RealFlightSystems/ufo29/sw/Arduino/ufo29/README.md

## Neopixel for Attiny85

- Support AttinyCore and Adafruit Neopixel library for saucer
- Support a few common programmable modes (with button)
