RealFlightSystems/ufo29/hw/ufo-29b.pdf

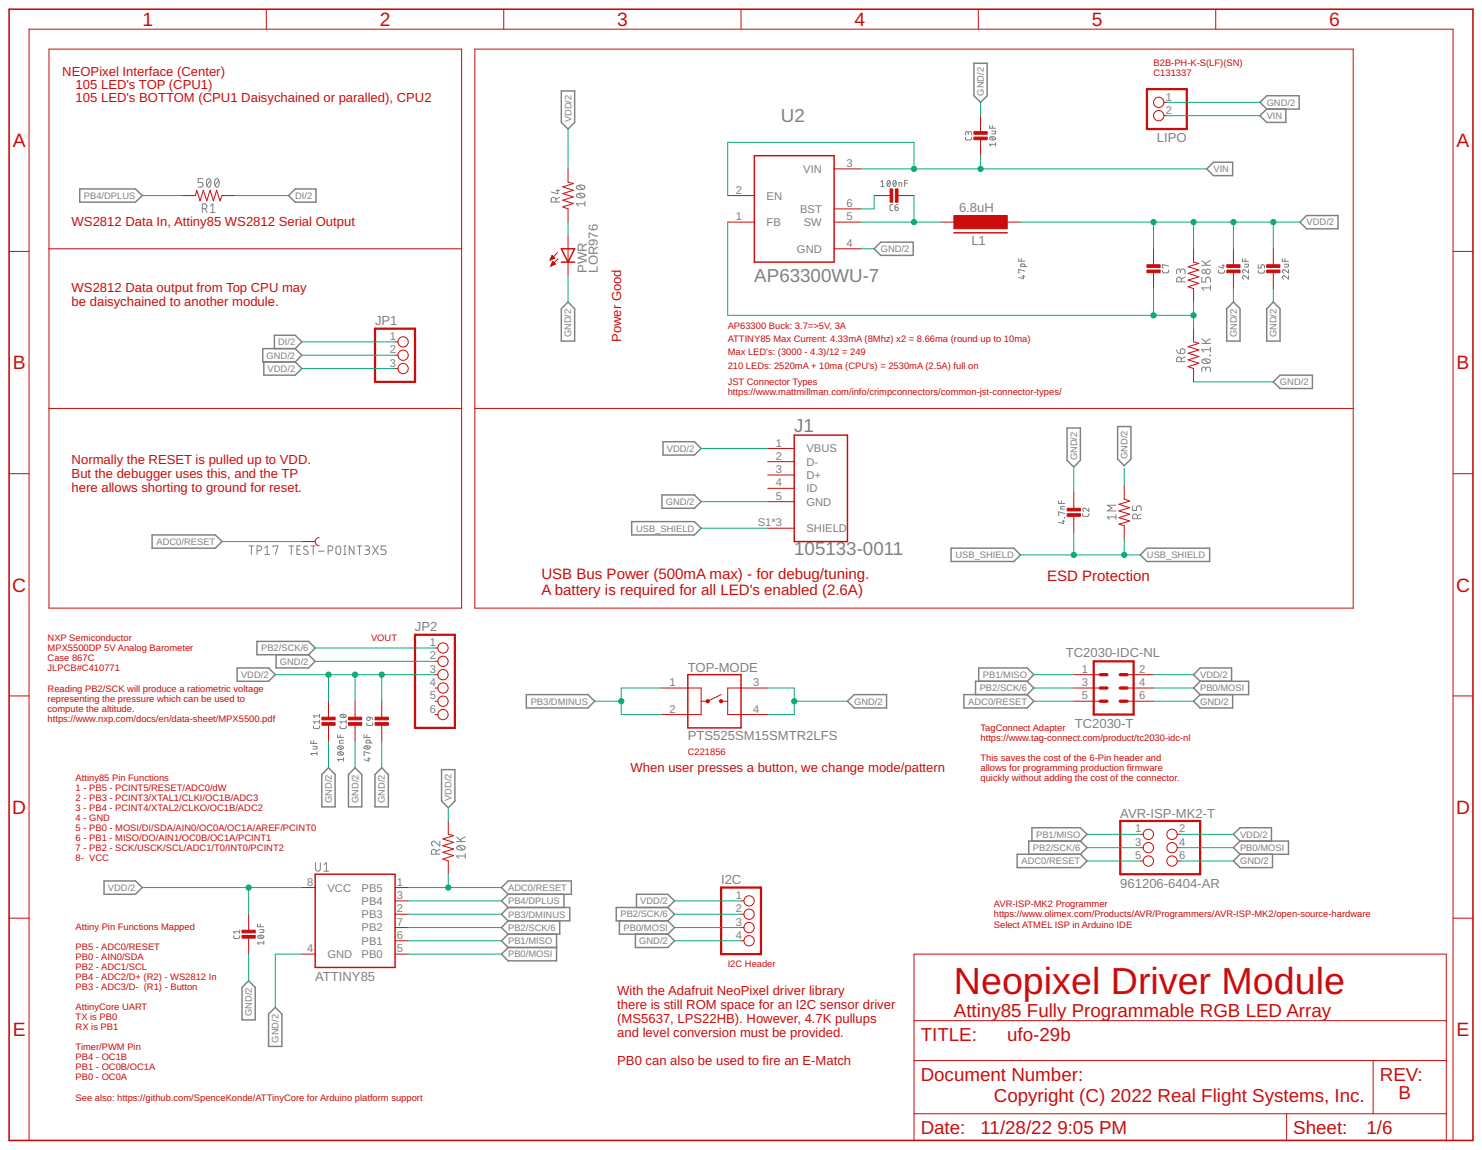
[picture p1: page 1]

NEOPixel Interface (Center) WS2812 Data In, Attiny85 WS2812 Serial Output
105 LED's TOP (CPU1) 105 LED's BOTTOM (CPU1 Daisychained or paralled), CPU2

WS2812 Data output from Top CPU may be daisychained to another module.

ATTINY85 Max Current: 4.33mA (8Mhz) x2 = 8.66ma (round up to 10ma) AP63300 Buck: 3.7=>5V, 3A Max LED's: (3000 - 4.3)/12 = 249

210 LEDs: 2520mA + 10ma (CPU's) = 2530mA (2.5A) full on
JST Connector Types https://www.mattmillman.com/info/crimpconnectors/common-jst-connector-types/

Normally the RESET is pulled up to VDD. But the debugger uses this, and the TP

here allows shorting to ground for reset.

USB Bus Power (500mA max) - for debug/tuning. A battery is required for all LED's enabled (2.6A)

NXP Semiconductor MPX5500DP 5V Analog Barometer Case 867C

JLPCB#C410771 Reading PB2/SCK will produce a ratiometric voltage

representing the pressure which can be used to
compute the altitude. https://www.nxp.com/docs/en/data-sheet/MPX5500.pdf

TagConnect Adapter https://www.tag-connect.com/product/tc2030-idc-nl This saves the cost of the 6-Pin header and

When user presses a button, we change mode/pattern

allows for programming production firmware
quickly without adding the cost of the connector.

3 - PB4 - PCINT4/XTAL2/CLKO/OC1B/ADC2
4 - GND
5 - PB0 - MOSI/DI/SDA/AIN0/OC0A/OC1A/AREF/PCINT0
6 - PB1 - MISO/DO/AIN1/OC0B/OC1A/PCINT1
7 - PB2 - SCK/USCK/SCL/ADC1/T0/INT0/PCINT2
8- VCC

AVR-ISP-MK2 Programmer https://www.olimex.com/Products/AVR/Programmers/AVR-ISP-MK2/open-source-hardware Select ATMEL ISP in Arduino IDE
Neopixel Driver Module
Attiny85 Fully Programmable RGB LED Array
TITLE:

Attiny Pin Functions Mapped PB5 - ADC0/RESET PB0 - AIN0/SDA

PB2 - ADC1/SCL PB4 - ADC2/D+ (R2) - WS2812 In PB3 - ADC3/D- (R1) - Button AttinyCore UART

With the Adafruit NeoPixel driver library
there is still ROM space for an I2C sensor driver
(MS5637, LPS22HB). However, 4.7K pullups and level conversion must be provided. PB0 can also be used to fire an E-Match

TX is PB0 RX is PB1 Timer/PWM Pin PB4 - OC1B

See also: https://github.com/SpenceKonde/ATTinyCore for Arduino platform support

Document Number: Copyright (C) 2022 Real Flight Systems, Inc. | REV: B

Date: 11/28/22 9:05 PM | Sheet: 1/6

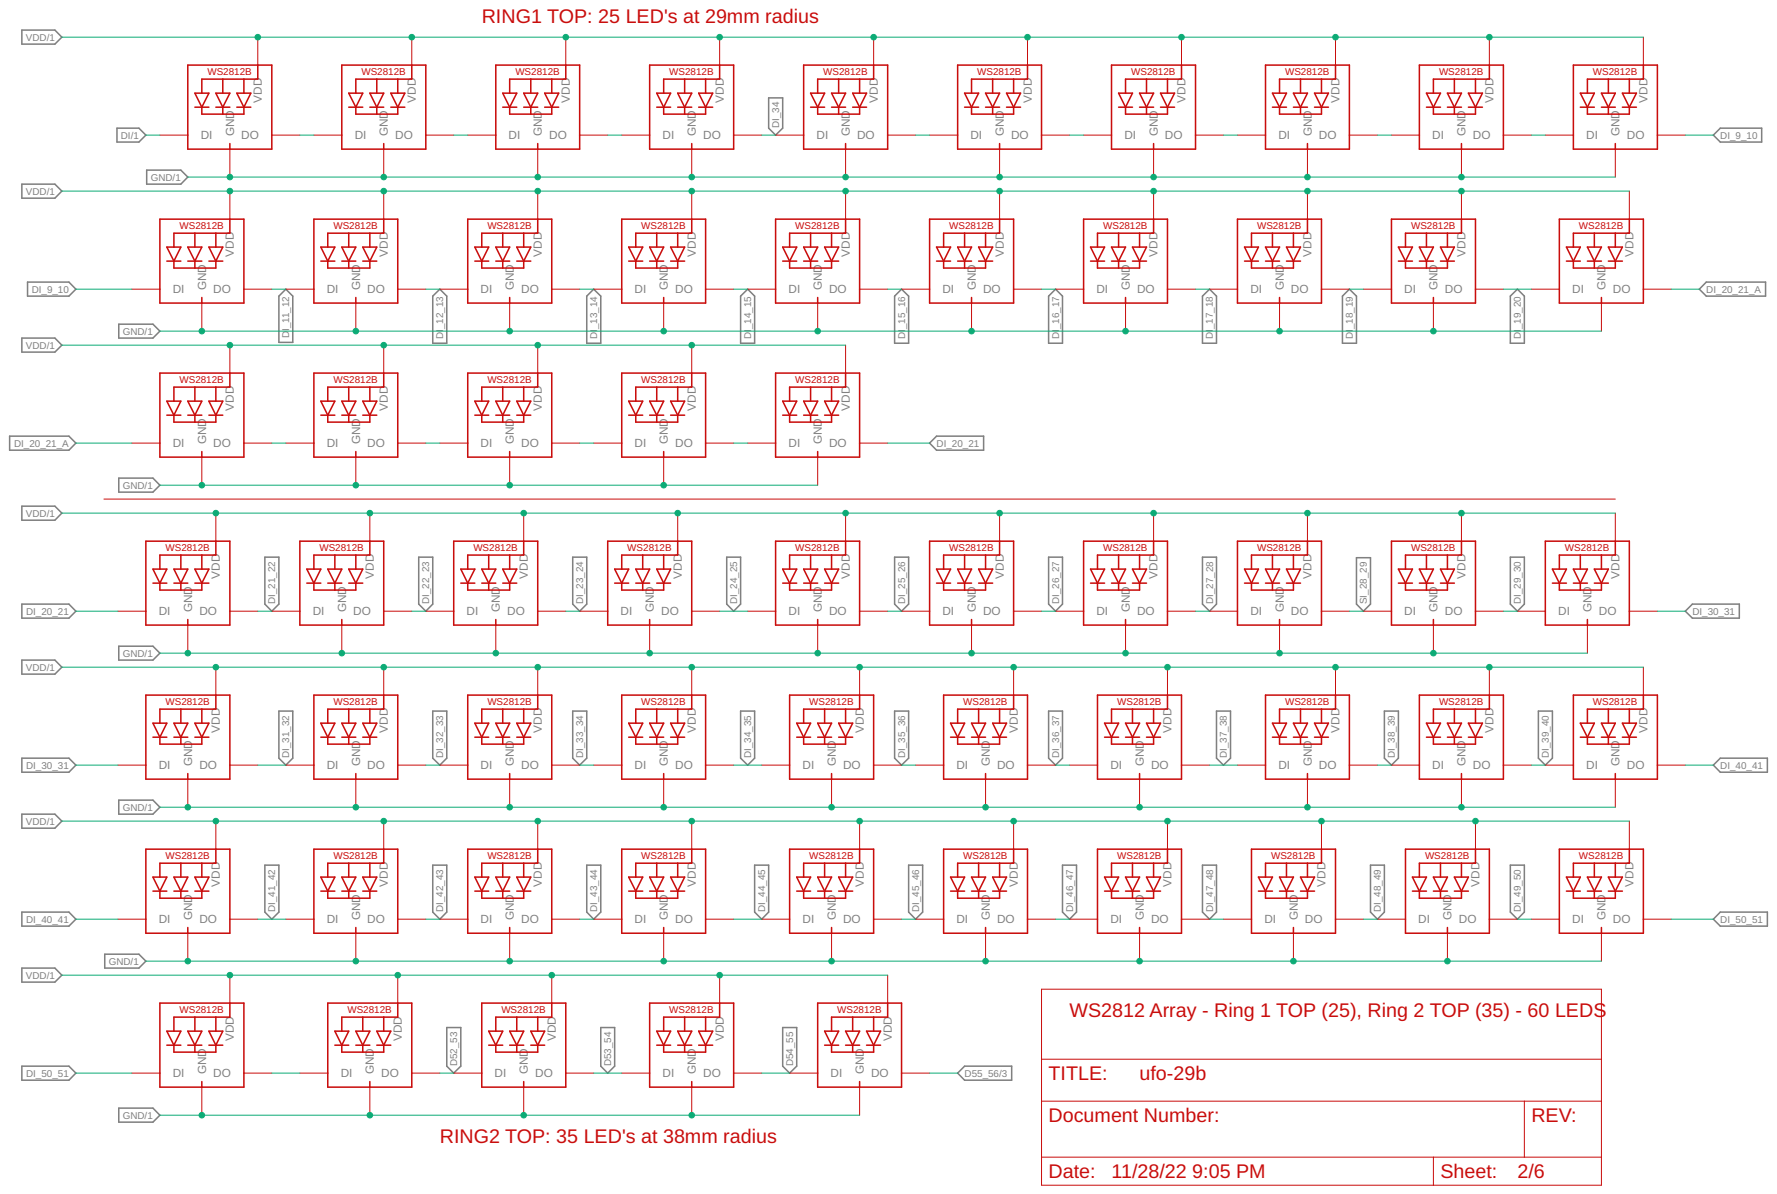
[picture p2: page 2]

RING1 TOP: 25 LED's at 29mm radius

Document Number: | REV:

RING2 TOP: 35 LED's at 38mm radius

Date: 11/28/22 9:05 PM | Sheet: 2/6

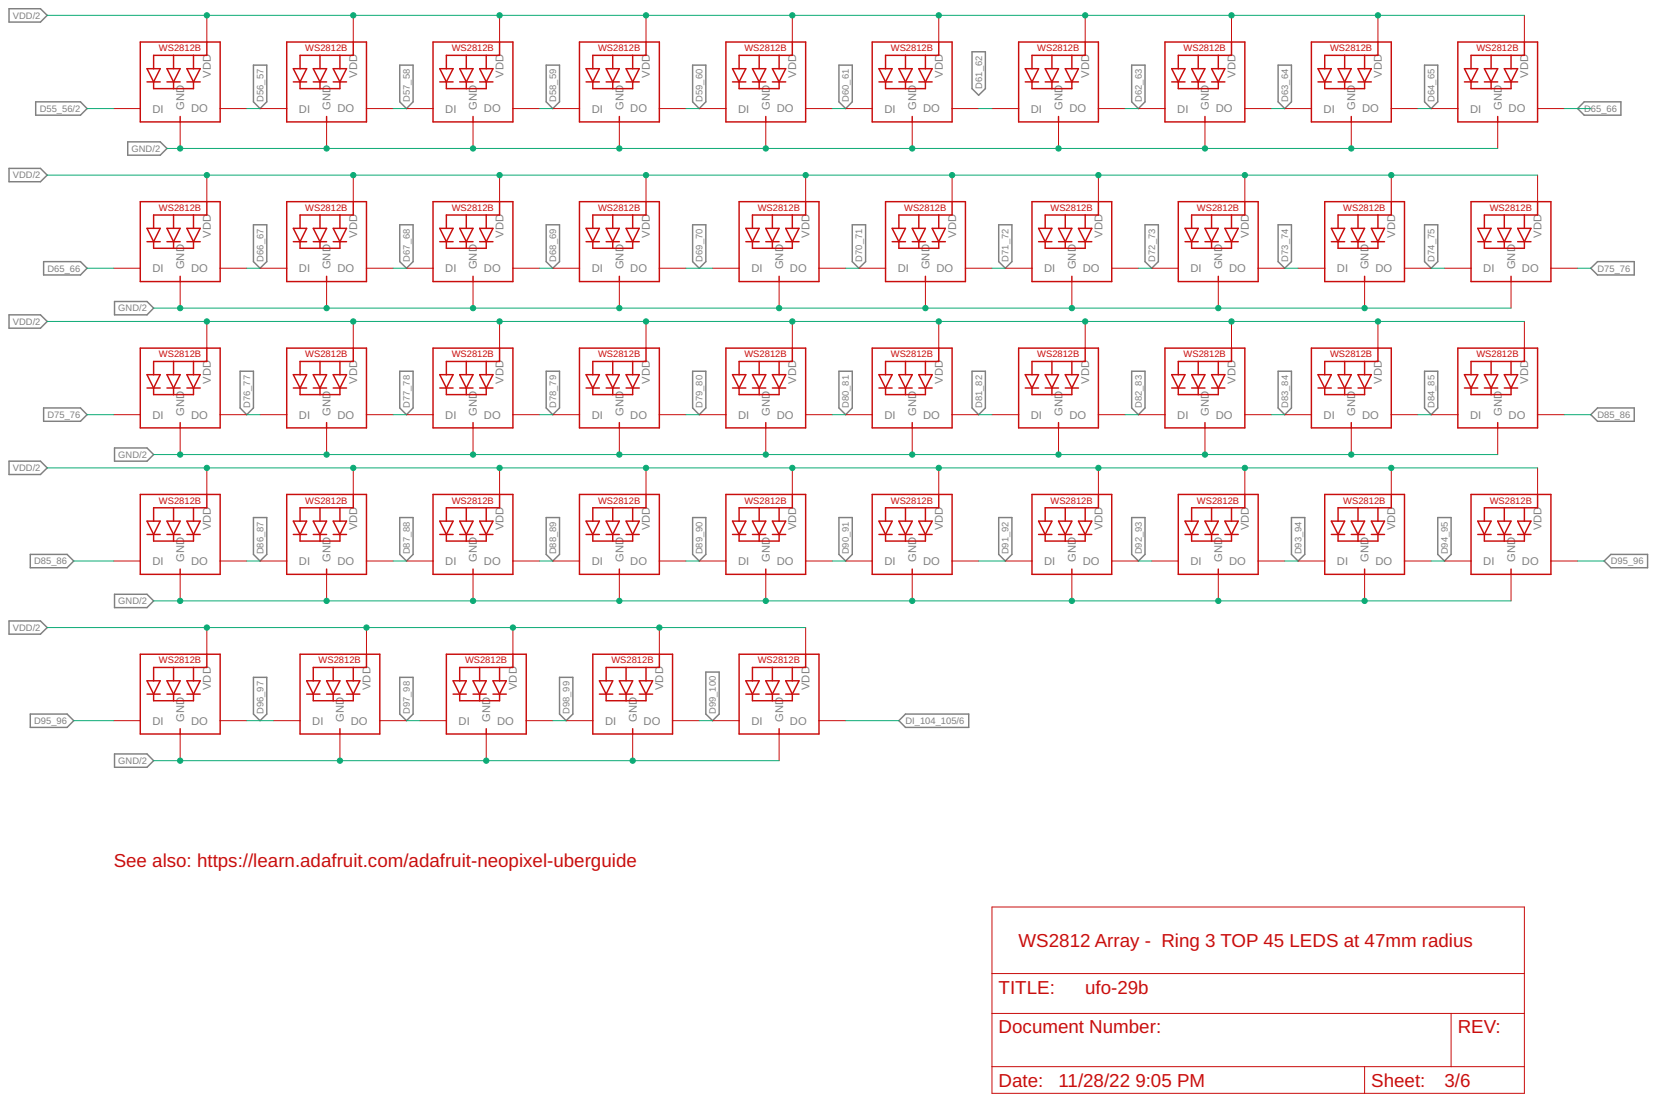
[picture p3: page 3]

See also: https://learn.adafruit.com/adafruit-neopixel-uberguide

Document Number: | REV:

Date: 11/28/22 9:05 PM | Sheet: 3/6

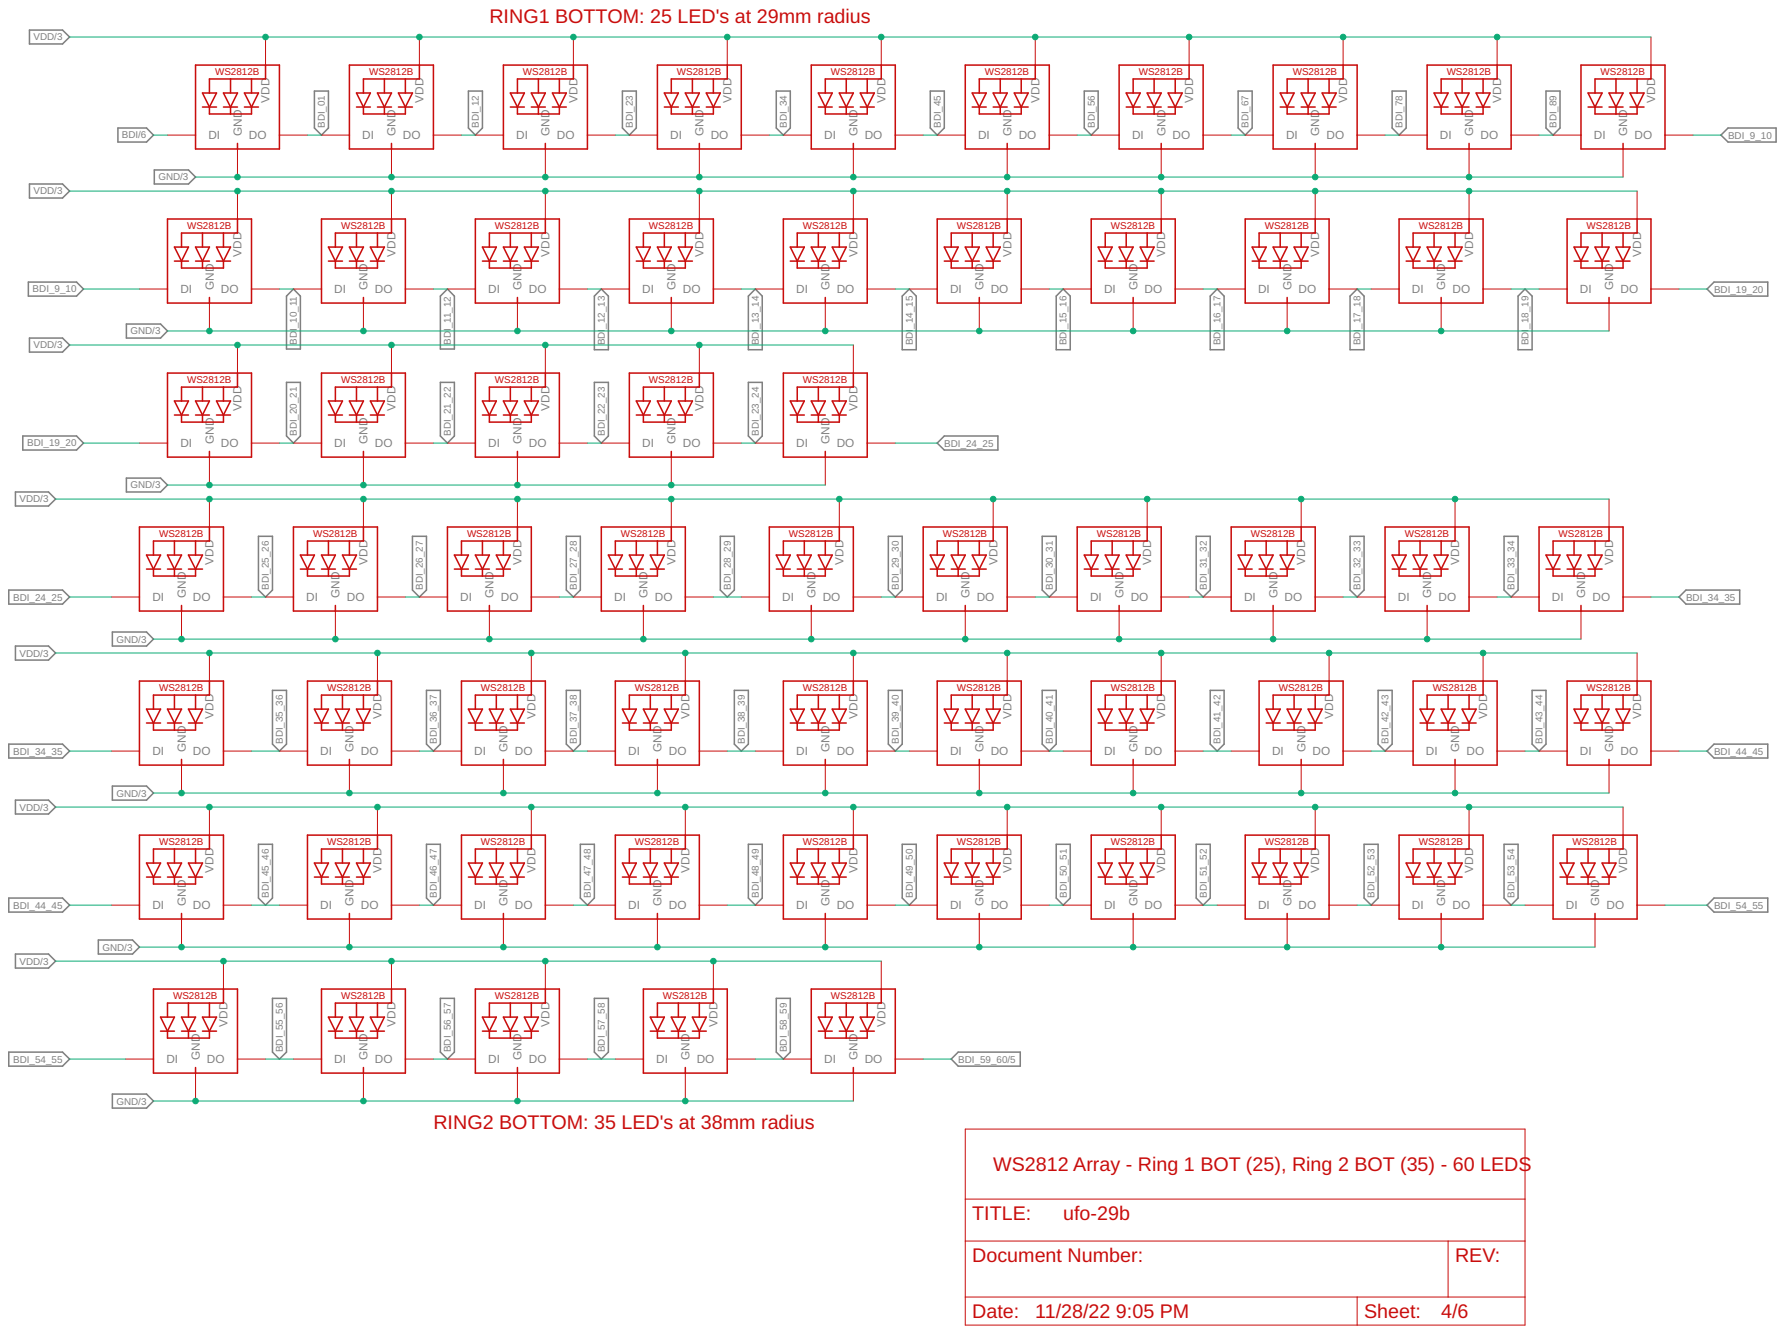
[picture p4: page 4]

RING2 BOTTOM: 35 LED's at 38mm radius

WS2812 Array - Ring 1 BOT (25), Ring 2 BOT (35) - 60 LEDS

Document Number: | REV:

Date: 11/28/22 9:05 PM | Sheet: 4/6

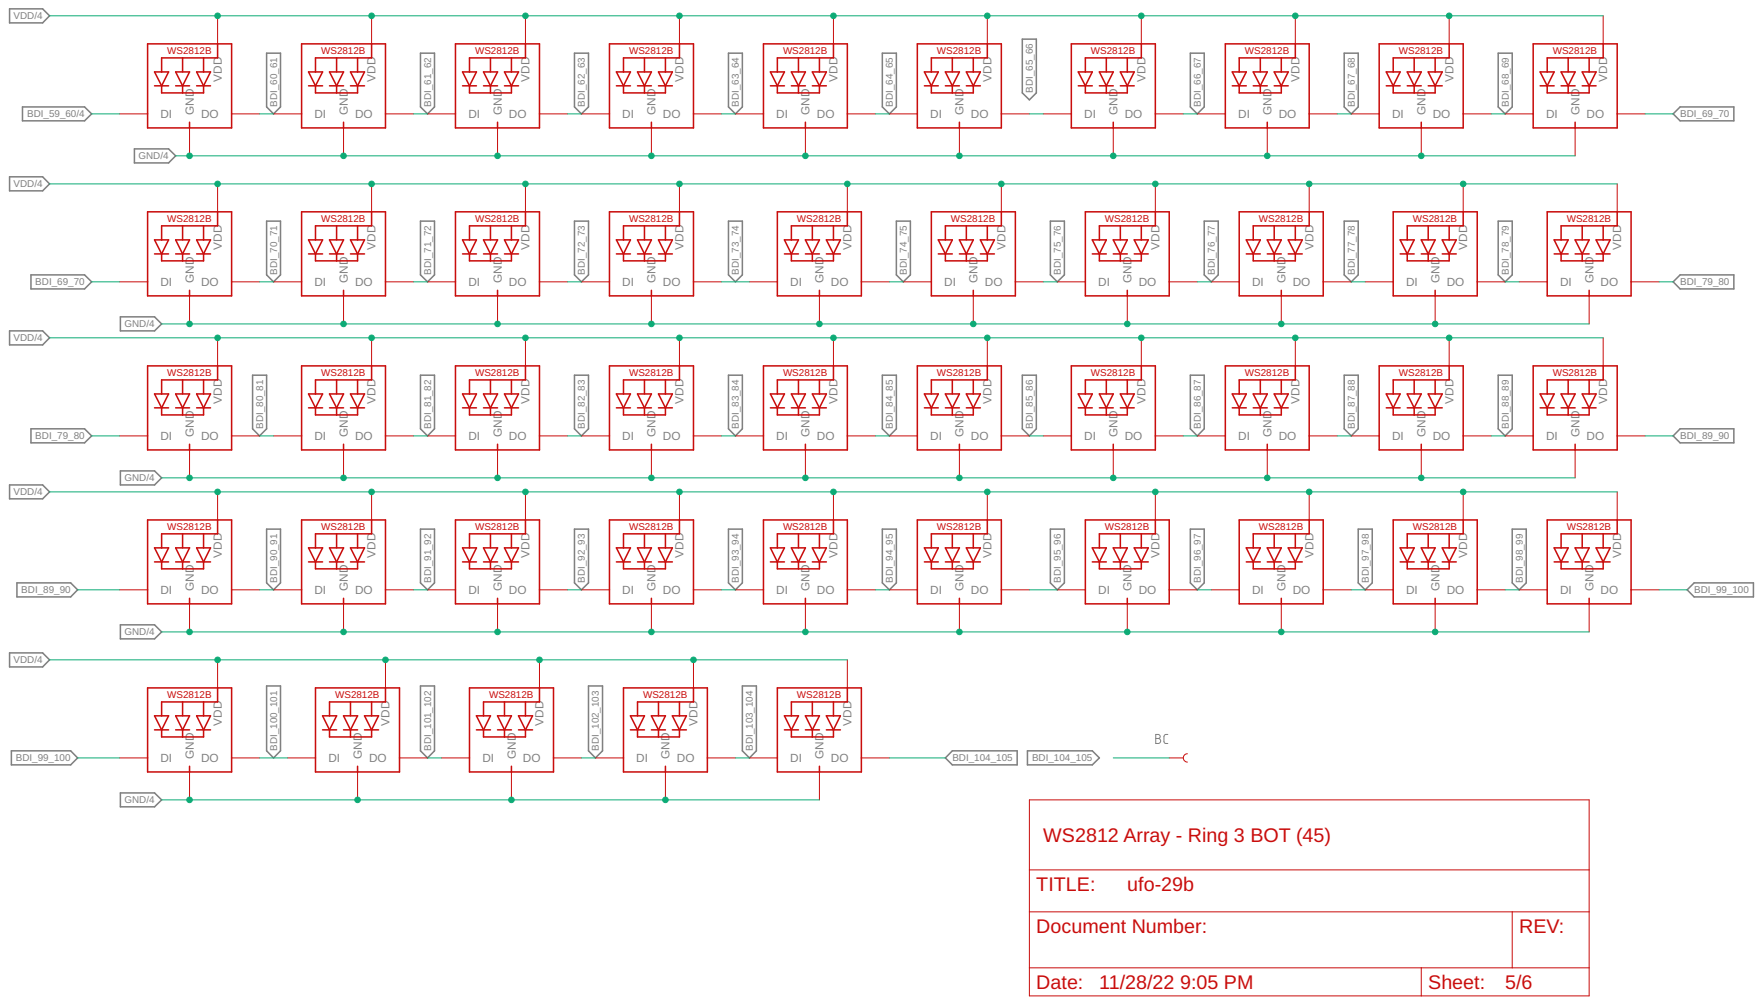
[picture p5: page 5]

Document Number: | REV:

Date: 11/28/22 9:05 PM | Sheet: 5/6

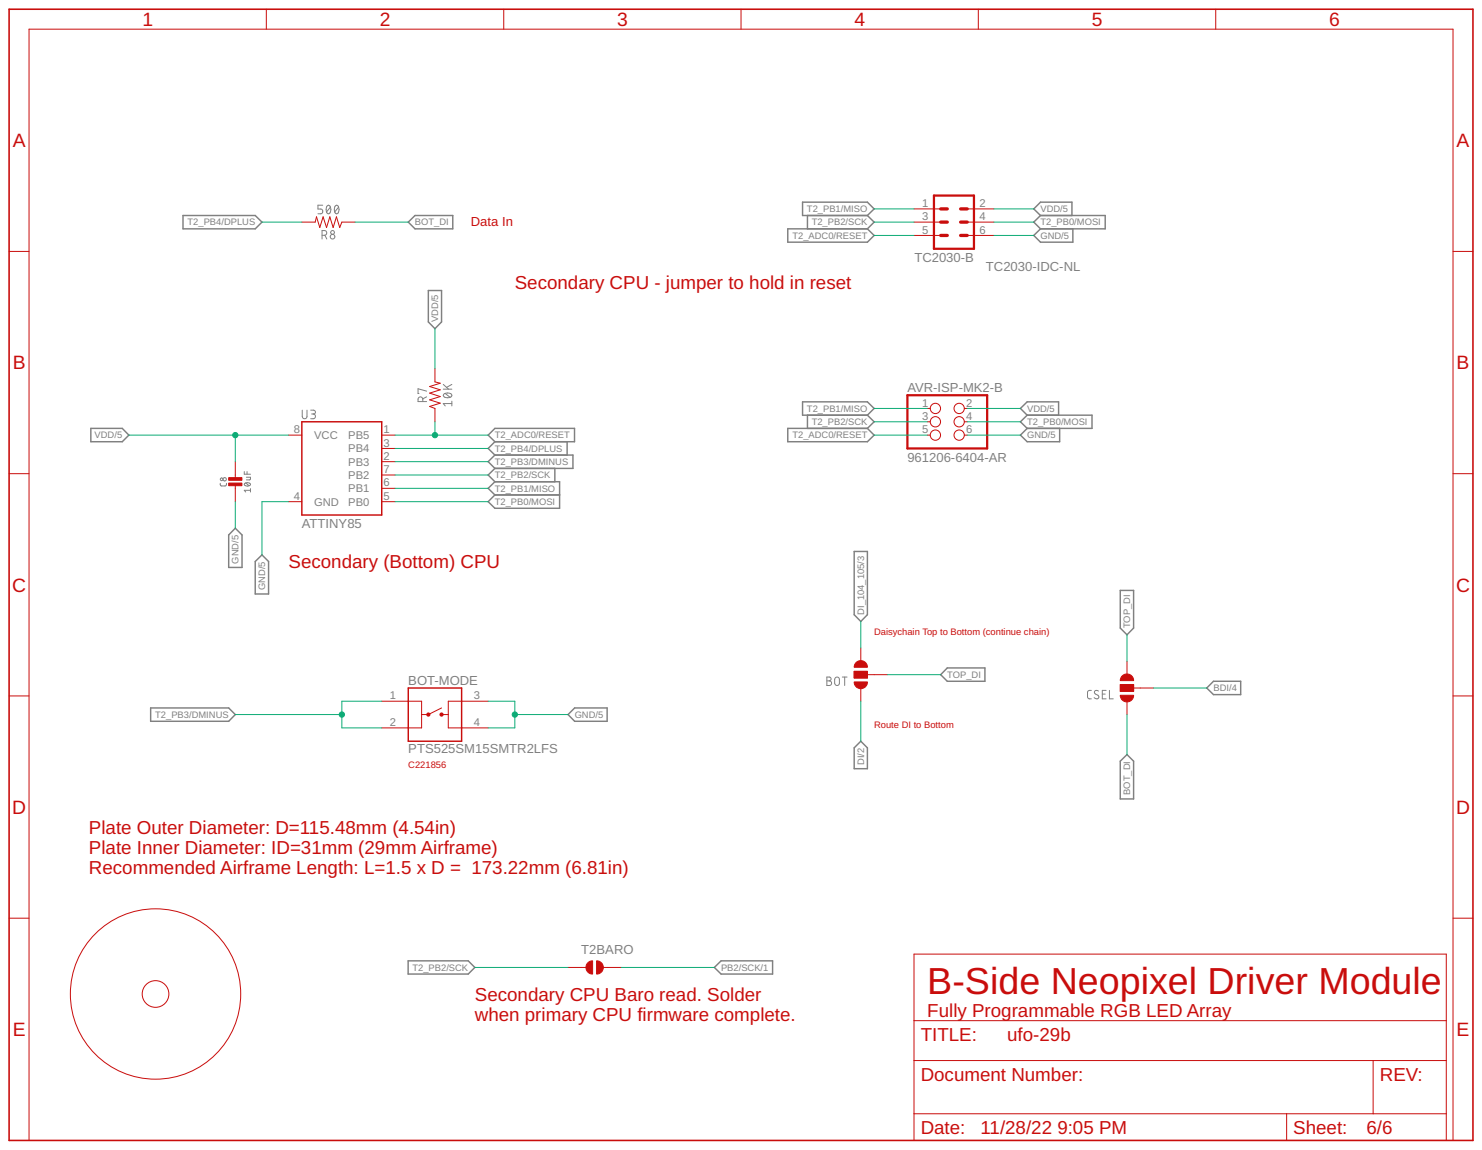
[picture p6: page 6]

Secondary CPU - jumper to hold in reset

Daisychain Top to Bottom (continue chain)

Route DI to Bottom Plate Outer Diameter: D=115.48mm (4.54in)

Plate Inner Diameter: ID=31mm (29mm Airframe)
Recommended Airframe Length: L=1.5 x D = 173.22mm (6.81in)

T2_PB2/SCK
Secondary CPU Baro read. Solder
when primary CPU firmware complete.

B-Side Neopixel Driver Module

Document Number: | REV:

Date: 11/28/22 9:05 PM | Sheet: 6/6
